AustinAAG/BiPAP_Ventilator/README.md

# BiPAP Ventilator
 All code for BiPAP project
