AustinAAG/BiPAP_Ventilator/PCB/BiPAP PCB BOM V2 Released.xlsx

Comment | Designator | Footprint | LCSC Part #（optional）
.1uF | C1, C2 | C0805 | C49678
180Ω | R5 | R0805 | C25270
1KΩ | R1,R2,R3,R4 | R0805 | C17513
