AustinAAG/BiPAP_Ventilator/Data_Sheets/Datasheets/Component Comparison.xlsx

Sheet: Sheet1
Part Number | Description | V_RM | V_RWM
BC337
1N4148 | Fast Switching Diode | 100 | 75

Sheet: Speaker
 | CEM-1203(42) (Current) | LCSC #C968749
Oscillation Frequency | 2048 | 2048
Operating Voltage | 2-5 | 3-5
Rated Voltage | 3.3 | 3.5
Current Consumption | <=35 | <=35
Sound Pressure Level | >=85 | >=85
Coil Resistance | 16+/-4 | 42+/-6.3
Dimension | 12 x H8.5mm | 12 x H8.5mm

Sheet: 1N4148 Diode
 | Fairchild BC337 |  | 1N4148 - Current | LCSC C444720
Collector-Emitter Voltage |  | Vrm | 100 | 100
C |  | Vrwm | 75 | 75
 |  | Vr | 53 | 53
 |  | Ifm | 300 | 300
 |  | Io | 150 | 150
 |  | Ifsm | 1 @ 1.0s, 2 @ 1us | 1 @ 1.0s, 2 @ 1us
 |  | Pd | 500 | 410
 |  |  |  | Slkor(SLKORMICRO Elec.)|Slkor(SLKORMICRO Elec.) 1N4148W|Switching Diode|LCSC (https://lcsc.com/product-detail/Switching-Diode_Slkor-SLKORMICRO-Elec-1N4148W_C444720.html)

Sheet: BC337 Transistor
 | BC337 - Current | LCSC #C236949
**Same product |  | ON Semiconductor|ON Semiconductor BC33740TA|Transistors (NPN/PNP)|LCSC (https://lcsc.com/product-detail/Transistors-NPN-PNP_ON-Semiconductor-ON-BC33740TA_C236949.html)
