AustinAAG/BiPAP_Ventilator/Data_Sheets/Transducer Option Breakdown.xlsx

Option | Model Number | Type | Configuration | Ports | Fluid | Diagnostics | Range | Address | Supply | # In Stock | Price | Link
Original | HSCDRRN010ND2A3 | High Accuracy, Compensated/Amplified | Dual Inline Pin | Dual Radial Barbed Ports (Same Side) | Dry Gases Only | No | +/- 10 in H2O Differential | 0x28 | 3.3 | 0 | $68.76 | https://www.mouser.com/ProductDetail/Honeywell/HSCDRRN010ND2A3
1 | HSCMRRN010ND3A3 | High Accuracy, Compensated/Amplified | Surface Mount | Dual Radial Barbed Ports (Same Side) | Dry Gases Only | No | +/- 10 in H2O Differential | 0x38 | 3.3 | 45 | $68.58 | https://www.mouser.com/ProductDetail/Honeywell/HSCMRRN010ND3A3?qs=4indQ9AG%252BqFEBM8FHk5y4Q%3D%3D
2 | HSCDRRN010ND3A3 | High Accuracy, Compensated/Amplified | Dual Inline Pin | Dual Radial Barbed Ports (Same Side) | Dry Gases Only | No | +/- 10 in H2O Differential | 0x38 | 3.3 | 3 | $67.40 | https://www.mouser.com/ProductDetail/Honeywell/HSCDRRN010ND3A3?qs=FIB5FJLAMZP1eeoK7gBavg%3D%3D
3 | HSCDRRD010ND7A3 | High Accuracy, Compensated/Amplified | Dual Inline Pin | Dual Radial Barbed Ports (Same Side) | Dry Gases Only | Yes | +/- 10 in H2O Differential | 0x78 | 3.3 | 44 | $69.09 | https://www.mouser.com/ProductDetail/Honeywell/HSCDRRD010ND7A3?qs=FiQKt8VsdiDajtOBIMIbrg%3D%3D
4 | HSCDRRN010ND7A3 | High Accuracy, Compensated/Amplified | Dual Inline Pin | Dual Radial Barbed Ports (Same Side) | Dry Gases Only | No | +/- 10 in H2O Differential | 0x78 | 3.3 | 15 | $66.18 | https://www.onlinecomponents.com/honeywell/hscdrrn010nd7a3-48159372.html
