AustinAAG/BiPAP_Ventilator/Box/91251A109_BLACK-OXIDE ALLOY STEEL SOCKET HEAD SCREW.IGS

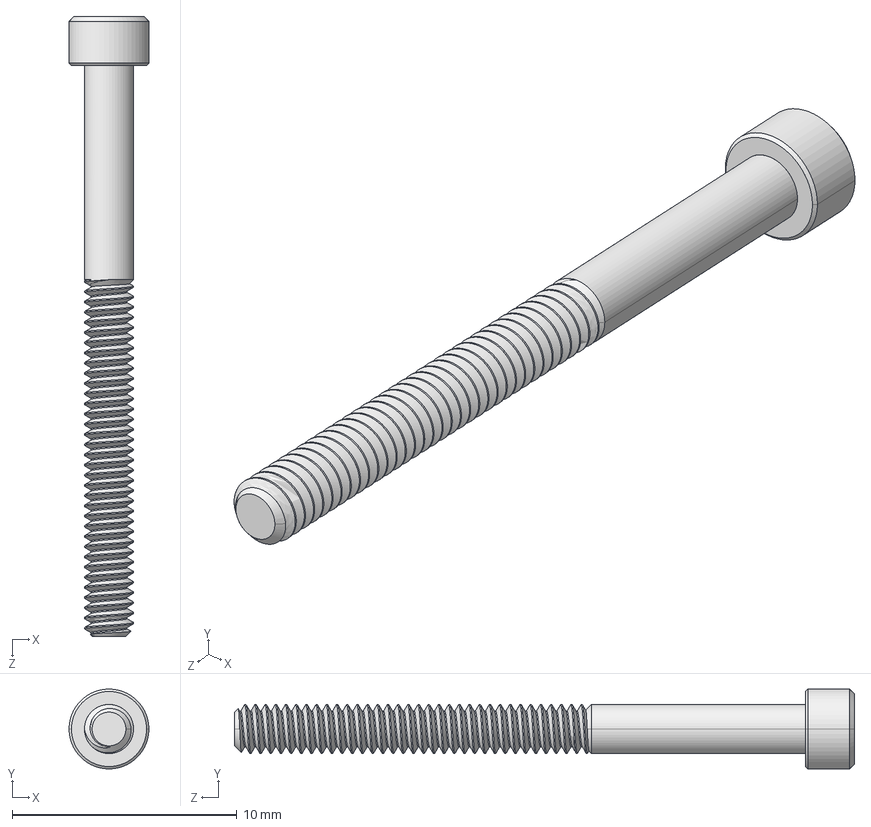
[picture p1: CAD file, 2021-07-05]
Box/91251A109_BLACK-OXIDE ALLOY STEEL SOCKET HEAD SCREW.IGS
3.56 x 3.56 x 27.6 mm
