AustinAAG/BiPAP_Ventilator/Box/91251A826_BLACK-OXIDE ALLOY STEEL SOCKET HEAD SCREW.STEP

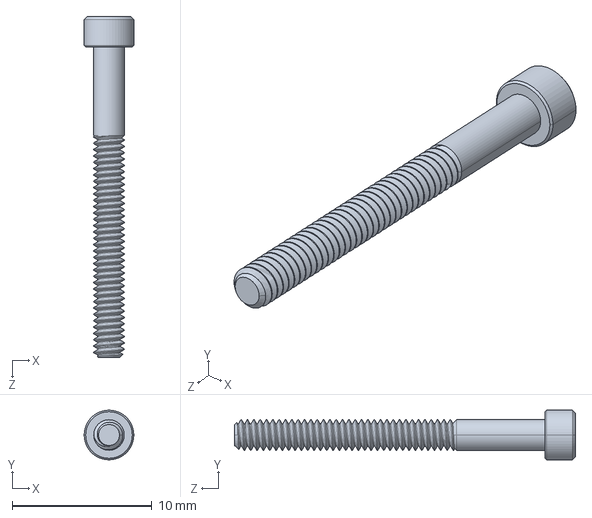
[picture p2: CAD file, 2021-07-05]
Box/91251A826_BLACK-OXIDE ALLOY STEEL SOCKET HEAD SCREW.STEP
3.56 x 3.56 x 24.4 mm
