AustinAAG/BiPAP_Ventilator/(list of files, cad)

Other CAD files:
Box/1 inch screw.STEP
Box/1 inch screw_step.prt
Box/1-8 2-56 Screw for MSP_igs.prt
Box/2-56 Heat Set Insert_step.prt
Box/3-16 2-56 Screw for top_igs.prt
Box/91251A826_BLACK-OXIDE ALLOY STEEL SOCKET HEAD SCREW_step.prt
Box/BoxAssy.prt
Box/MSP432.prt
Box/PressureTubeAdapter.prt
Box/VboxTop.prt
Box/VentilatorBox.prt
Box/constraint.prt
Box/grainger-1ddu3_stp.prt
Box/guide.prt
Box/newventInches.prt
Box/newventuri - Copy - Copy.prt
Box/wire_cover.prt
