AustinAAG/BiPAP_Ventilator/Data_Sheets/Calibration Steps.docx

Calibration Steps

1. Set up the device according to the diagram below

Device

MFC

Flow Limiter

Facility Air

Analog transducer

DAQ – Current Module

DAQ – Voltage Module

Power Source

2. Check for leaks with a pressure test
3. Make sure that the power source is set at 3.3V and the circuit is open
4. Double check that the power and data pins for the pressure transducers are connected properly
  a. Pin 4 – Ground (Negative terminal in this case)
  b. Pin 3 – Data Voltage Out
  c. Pin 2 – Power source
5. Close the circuit on the power supply
6. Run the LabView program
7. Ensure that the pressure transducers are reading 0 Pa at 0 flow
  a. If it isn’t, change the value for the bias in the front panel
8. Stop the labview program when done calibrating
9. Start the LabView program and collect data for 30 sec.
10. Make sure that the flow limiter is closed (turn left)
11. Turn on the facility air
12. Turn the flow limiter to 0 LPM
13. Start the LabView program and collect data for 30 sec.
14. Do the same for 10, 20, 30, 40, 50, 75, 100, 125, 150, 200 LPM three times
15. Flip the direction of the box
16. Ensure that there are no leaks with a pressure test
17. Plot the pressure vs flow values on Matlab
18. Run a least square fit and determine the missing constant in the flow/pressure equation
