AustinAAG/BiPAP_Ventilator/PCB/BiPAP_PCB_V2_Released.brd

## EAGLE design PCB/BiPAP_PCB_V2_Released.brd (2021-07-05)

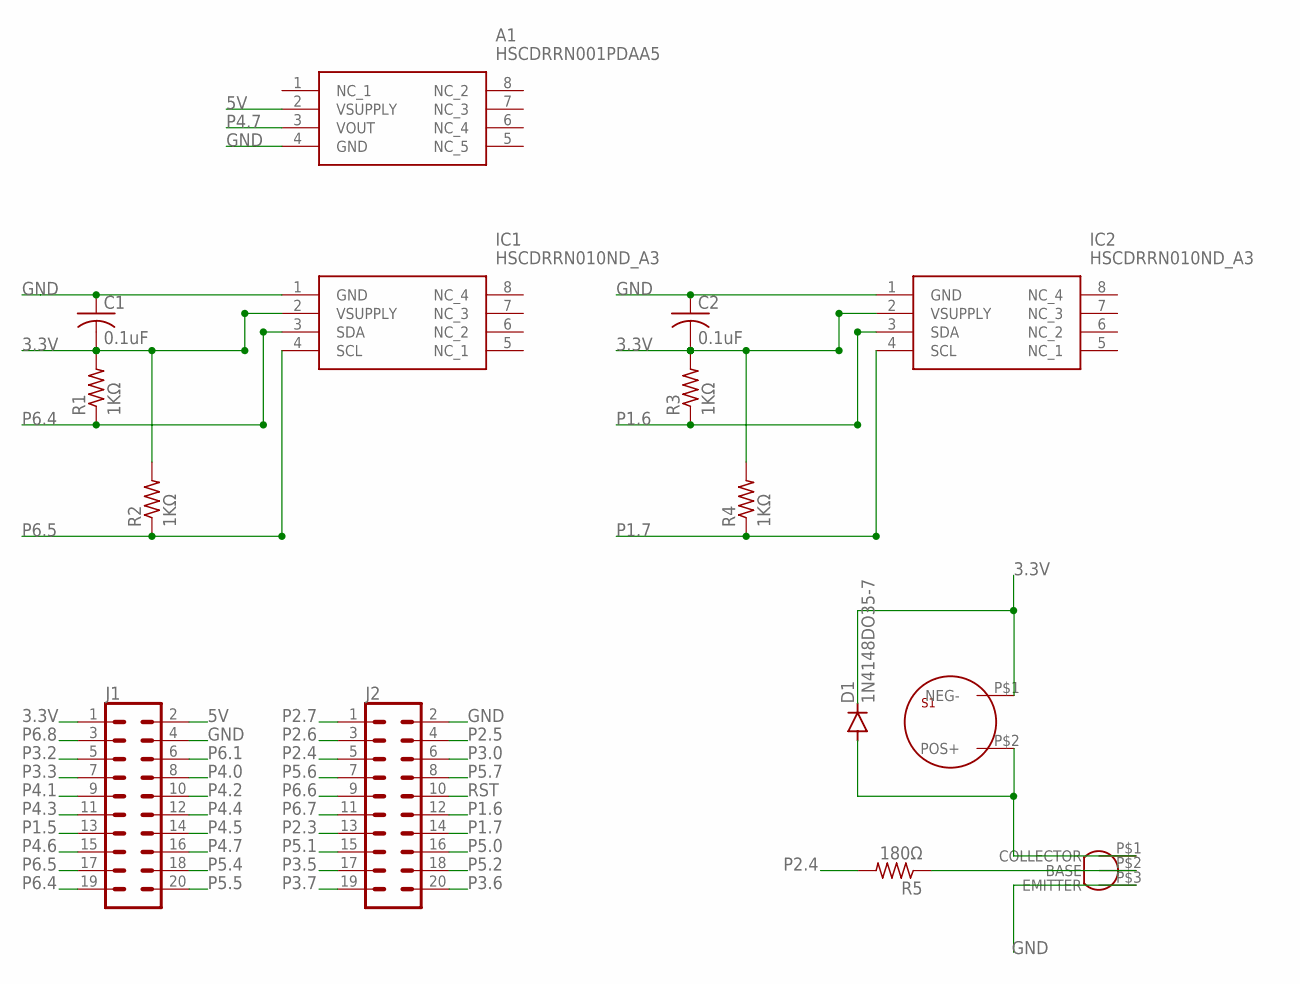
[picture p3: schematic BiPAP_PCB_V2_Released.sch]

Parts:
A1: HSCDRRN001PDAA5
C1, C2: 0.1uF; C0805
D1: 1N4148DO35-7; DO35-7
IC1, IC2: HSCDRRN010ND_A3; HSCDRRN010ND2A3
J1, J2: CONN_10X2; 2X10
R1, R2, R3, R4: 1KΩ; R0805
R5: 180Ω; R0805
S1: CEET120B085
T1: BC337

Connections:
3.3V: C1.2, C2.2, D1.C, IC1.2 (VSUPPLY), IC2.2 (VSUPPLY), J1.1, R1.2, R2.2, R3.2, R4.2, S1.P$1 (NEG-)
5V: A1.2 (VSUPPLY), J1.2
GND: A1.4 (GND), C1.1, C2.1, IC1.1 (GND), IC2.1 (GND), J1.4, J2.2, T1.P$3 (EMITTER)
unnamed: D1.A, S1.P$2 (POS+), T1.P$1 (COLLECTOR)
unnamed: R5.1, T1.P$2 (BASE)
P1.5: J1.13
P1.6: IC2.3 (SDA), J2.12, R3.1
P1.7: IC2.4 (SCL), J2.14, R4.1
P2.3: J2.13
P2.4: J2.5, R5.2
P2.5: J2.4
P2.6: J2.3
P2.7: J2.1
P3.0: J2.6
P3.2: J1.5
P3.3: J1.7
P3.5: J2.17
P3.6: J2.20
P3.7: J2.19
P4.0: J1.8
P4.1: J1.9
P4.2: J1.10
P4.3: J1.11
P4.4: J1.12
P4.5: J1.14
P4.6: J1.15
P4.7: A1.3 (VOUT), J1.16
P5.0: J2.16
P5.1: J2.15
P5.2: J2.18
P5.4: J1.18
P5.5: J1.20
P5.6: J2.7
P5.7: J2.8
P6.1: J1.6
P6.4: IC1.3 (SDA), J1.19, R1.1
P6.5: IC1.4 (SCL), J1.17, R2.1
P6.6: J2.9
P6.7: J2.11
P6.8: J1.3
RST: J2.10

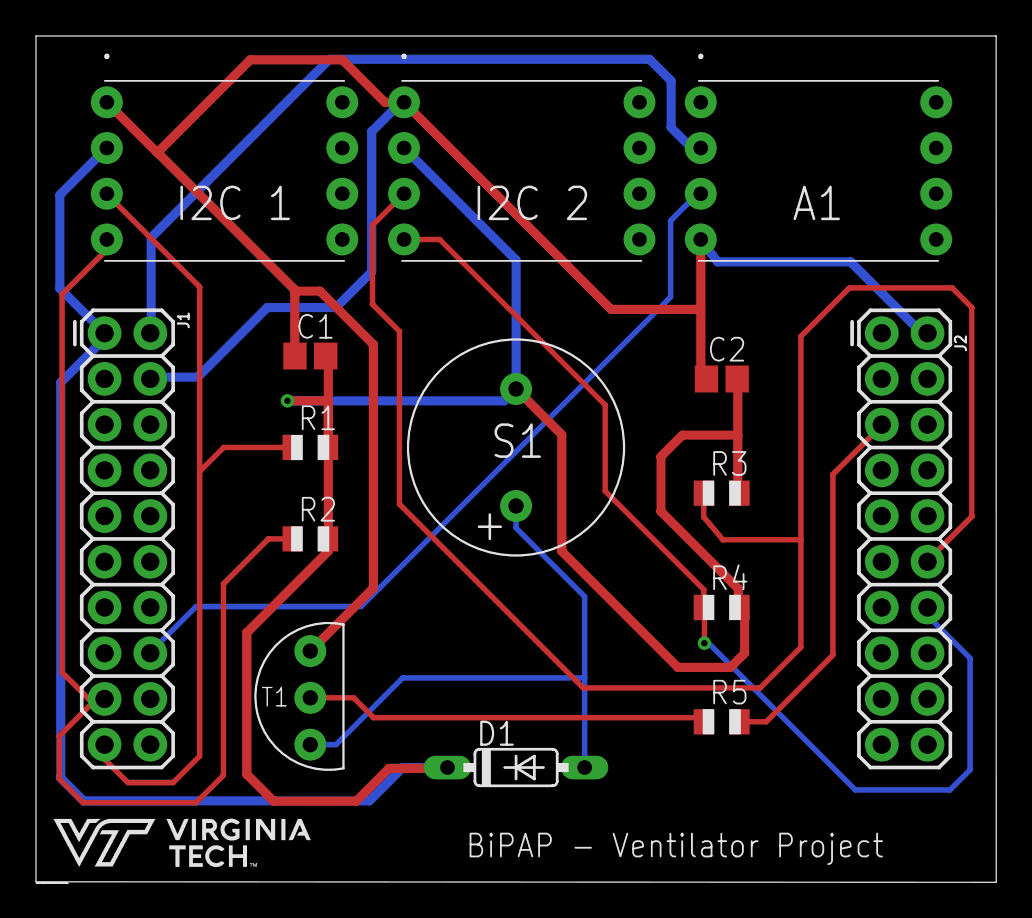
[picture p4: board BiPAP_PCB_V2_Released.brd from above]

Board: 2 copper layers, 53.3 x 47.0 mm, 15 parts (0 on the bottom side), 11 nets.
