AustinAAG/BiPAP_Ventilator/(commit log)

2020-05-26 all files we use
    adding all the files we have generated so team has access
    [startup_msp432p401r_ccs.obj]
2021-05-10 remove all old files
    [startup_msp432p401r_ccs.obj]
2021-05-12 Fixing Zero constants, Analog sensor, and prepping C code for pause button. Added more comments. Cleared unused code.
    [FontTest1.py, calculations.c, calculations.h, main.c]
2021-05-24 Fixed analog sensor and PWM conflicts
    [main.c]
2021-05-24 Added Stop Button
2021-06-24 Added self calibration functionality
2021-07-05 added supp files
    [1 inch screw.STEP, 1 inch screw_step.prt, 1-8 2-56 Screw for MSP_igs.prt, 2-56 Heat Set Insert_step.prt, 3-16 2-56 Screw for top_igs.prt, 91251A109_BLACK-OXIDE ALLOY STEEL SOCKET HEAD SCREW.IGS, 91251A826_BLACK-OXIDE ALLOY STEEL SOCKET HEAD SCREW.STEP, 91251A826_BLACK-OXIDE ALLOY STEEL SOCKET HEAD SCREW_step.prt]
2021-07-09 Fixed self calibration problems
    [FontTest1.py, main.c]
2021-08-09 Revert "meeting with dr meadows"
    This reverts commit 2b0eddf21553a1879fe8fad9cf2999cda4b22817.
    [FontTest1.py, main.c]
2021-08-09 corrected from misplaced commit
    [main.c]
